blazra/tdr/README.md

# TDR
TDR using Lattice ECP5 High Data Rate Transceiver
