blazra/tdr/docs/index.md

## TDR Docs

TDR [Interactive BOM](bom/ibom.html)
