blazra/tdr/boards/TDR/TDR.kicad_pcb

## KiCad design boards/TDR/TDR.kicad_pcb (2020-08-01)

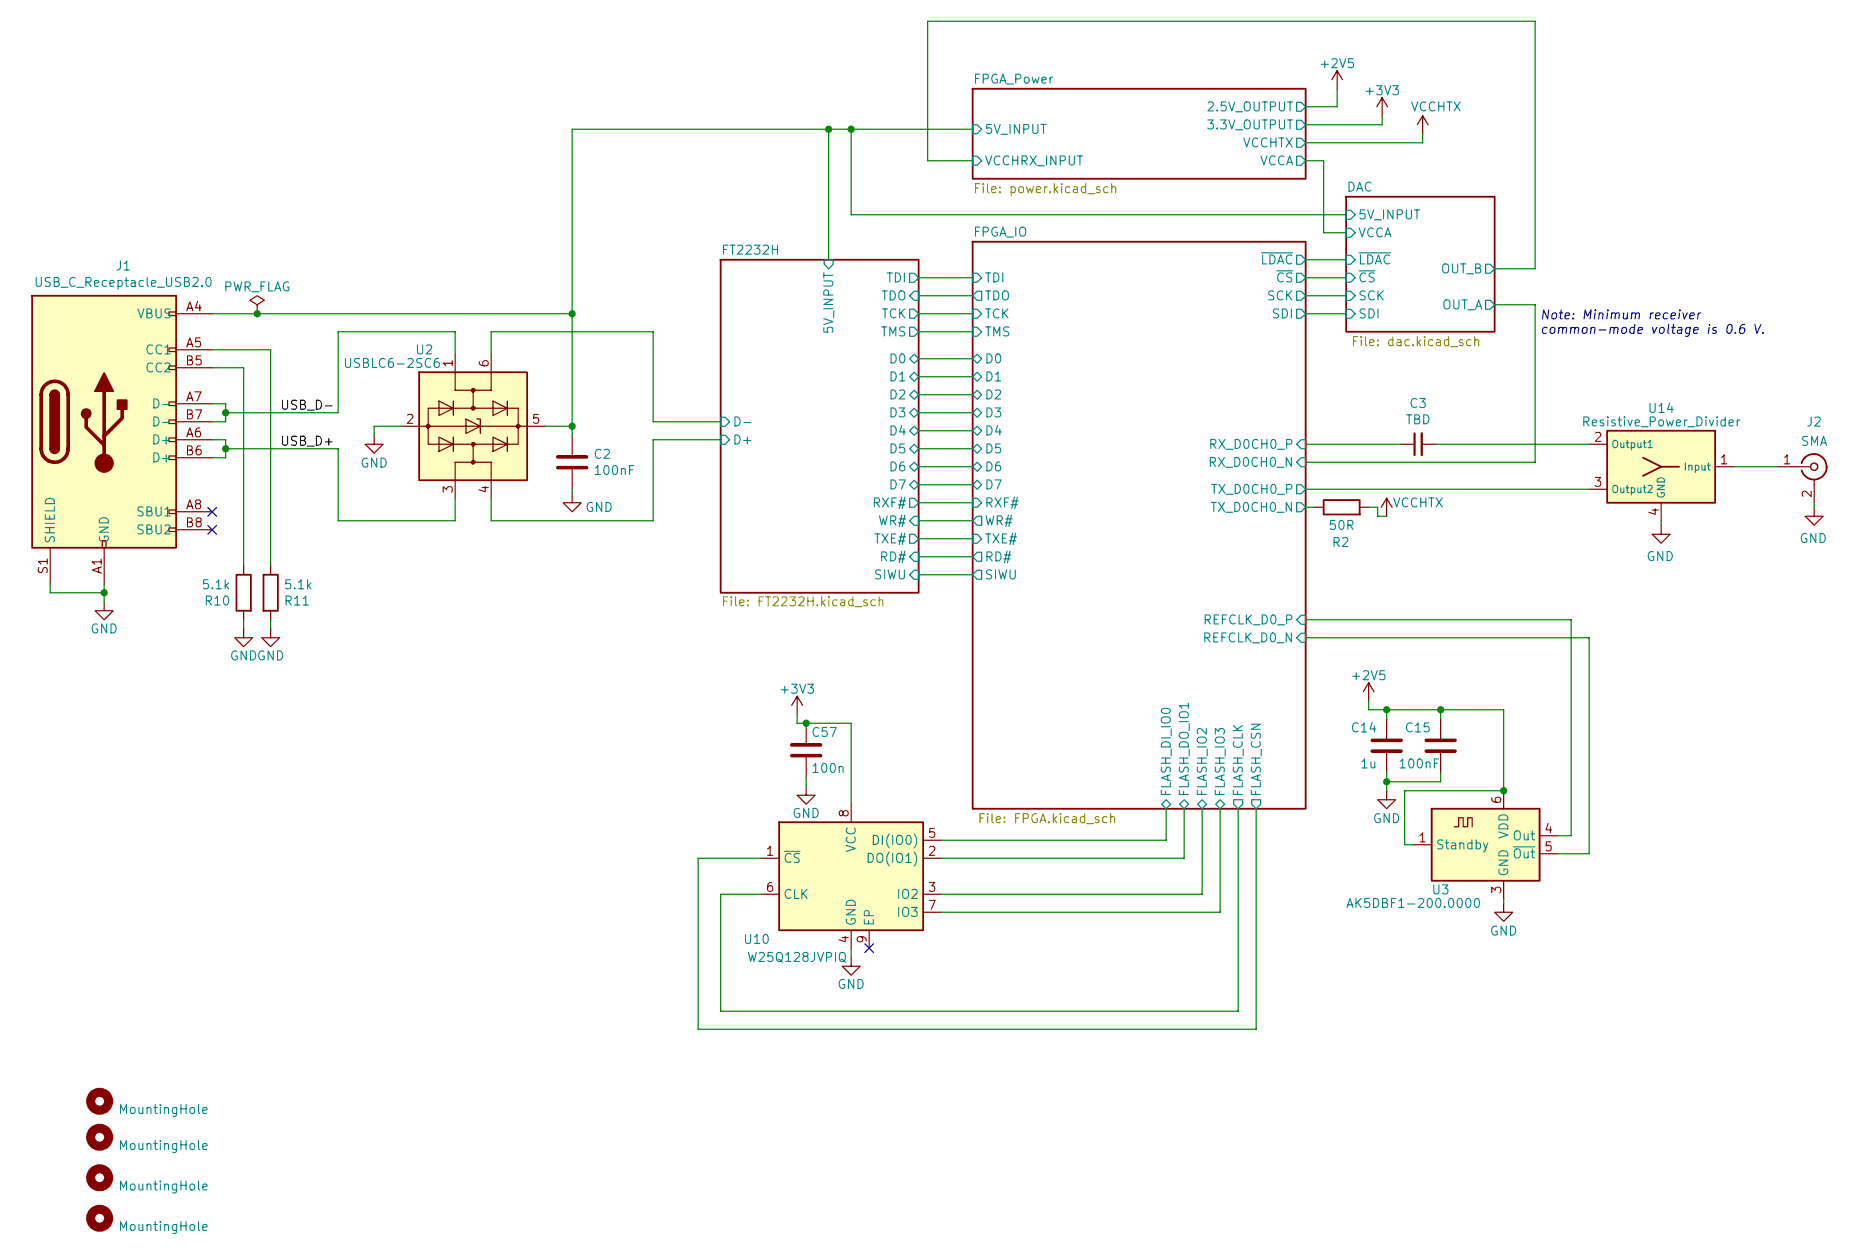
[picture p1: schematic TDR.kicad_sch, TDR, Top schematic]

Parts:
C2, C15: 100nF; C_0402_1005Metric
C3: TBD; C_0402_1005Metric
C14: 1u; C_0805_2012Metric
C57: 100n; C_0402_1005Metric
H1, H2, H3, H4: MountingHole; MountingHole_3.2mm_M3
J1: USB_C_Receptacle_USB2.0; USB_C_Receptacle_JAE_DX07S016
J2: SMA; Rosenberger_SMA_32K243-40ML5
R2: 50R; R_0402_1005Metric
R10, R11: 5.1k; R_0805_2012Metric
U2: USBLC6-2SC6; SOT-23-6
U3: AK5DBF1-200.0000; Oscillator_SMD_IDT_JS6-6_5.0x3.2mm_P1.27mm
U10: W25Q128JVPIQ; WSON-8-1EP_6x5mm_P1.27mm_EP3.4x4.3mm
U14: Resistive_Power_Divider; Susumu_PS2012G

Connections:
+2V5: C14.1, C15.1, U3.1 (Standby), U3.6 (VDD); also elsewhere on the board
+3V3: C57.1, U10.8 (VCC); also elsewhere on the board
/5V_INPUT: C2.1, J1.A4 (VBUS), J1.A9 (VBUS), J1.B4 (VBUS), J1.B9 (VBUS), U2.5 (VBUS); also elsewhere on the board
/D+: U2.4 (I/O2); also elsewhere on the board
/D-: U2.6 (I/O1); also elsewhere on the board
/FLASH_CLK: U10.6 (CLK); also elsewhere on the board
/FLASH_CSN: U10.1 (~CS); also elsewhere on the board
/FLASH_DI_IO0: U10.5 (DI(IO0)); also elsewhere on the board
/FLASH_DO_IO1: U10.2 (DO(IO1)); also elsewhere on the board
/FLASH_IO2: U10.3 (IO2); also elsewhere on the board
/FLASH_IO3: U10.7 (IO3); also elsewhere on the board
/REFCLK_D0_N: U3.5 (~Out); also elsewhere on the board
/REFCLK_D0_P: U3.4 (Out); also elsewhere on the board
/RX_D0CH0_P: C3.1; also elsewhere on the board
/TX_D0CH0_N: R2.1; also elsewhere on the board
/TX_D0CH0_P: U14.3 (Output2); also elsewhere on the board
/USB_D+: J1.A6 (D+), J1.B6 (D+), U2.3 (I/O2)
/USB_D-: J1.A7 (D-), J1.B7 (D-), U2.1 (I/O1)
GND: C2.2, C14.2, C15.2, C57.2, J1.A1 (GND), J1.A12 (GND), J1.B1 (GND), J1.B12 (GND), J1.S1 (SHIELD), J2.2 (Ext), R10.2, R11.2, U2.2 (GND), U3.3 (GND), U10.4 (GND), U14.4 (GND); also elsewhere on the board
unnamed: C3.2, U14.2 (Output1)
unnamed: J1.A5 (CC1), R11.1
unnamed: J1.B5 (CC2), R10.1
unnamed: J2.1 (In), U14.1 (Input)
VCCHTX: R2.2; also elsewhere on the board

Notes on the sheet:
Note: Minimum receiver common-mode voltage is 0.6 V.

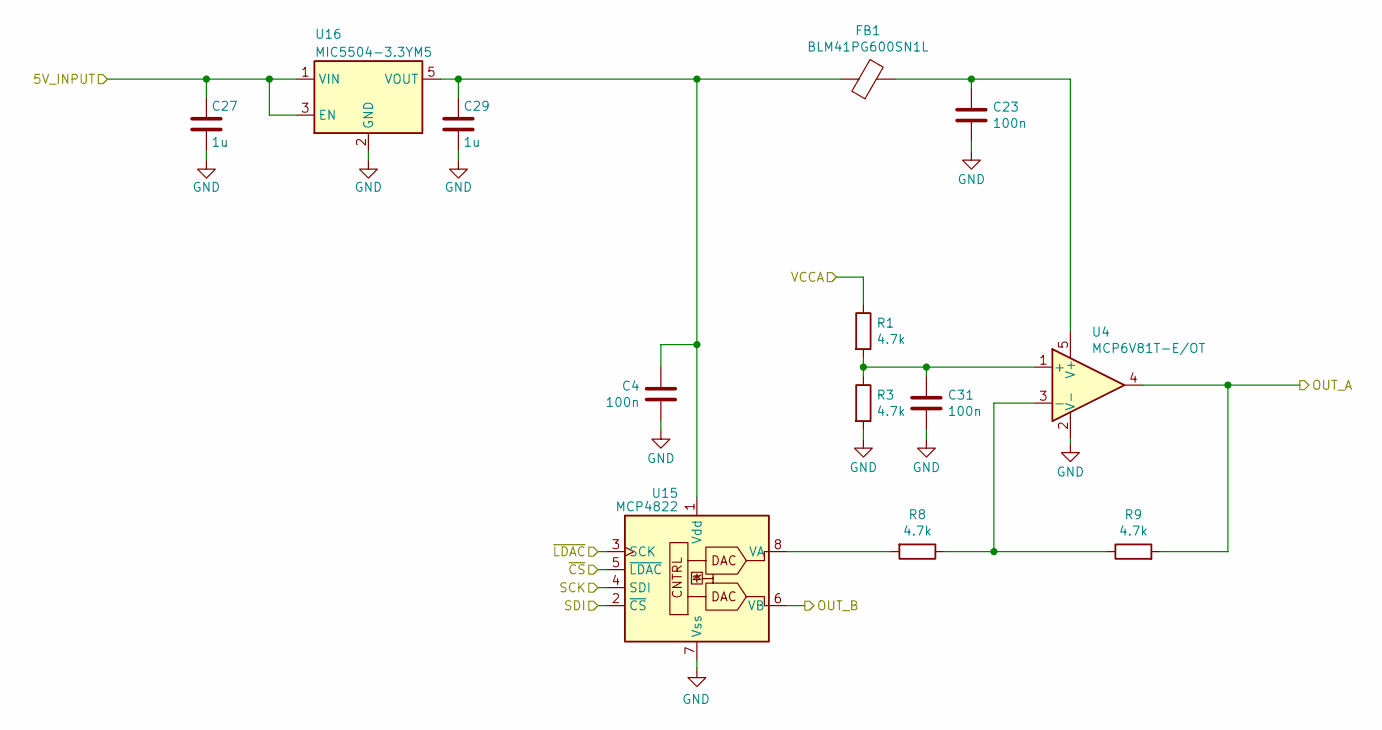
[picture p2: schematic dac.kicad_sch]

Parts:
C4, C23, C31: 100n; C_0402_1005Metric
C27, C29: 1u; C_0805_2012Metric
FB1: BLM41PG600SN1L; L_1806_4516Metric
R1, R3, R8, R9: 4.7k; R_0805_2012Metric
U4: MCP6V81T-E/OT; SOT-23-5
U15: MCP4822; MSOP-8_3x3mm_P0.65mm
U16: MIC5504-3.3YM5; SOT-23-5

Connections:
/5V_INPUT: C27.1, U16.1 (VIN), U16.3 (EN); also elsewhere on the board
/OUT_A: R9.2, U4.4; also elsewhere on the board
/OUT_B: U15.6 (VB); also elsewhere on the board
/SCK: U15.4 (SDI); also elsewhere on the board
/SDI: U15.2 (~CS); also elsewhere on the board
/VCCA: R1.1; also elsewhere on the board
/~CS: U15.5 (~LDAC); also elsewhere on the board
/~LDAC: U15.3 (SCK); also elsewhere on the board
GND: C4.2, C23.2, C27.2, C29.2, C31.1, R3.2, U4.2 (V-), U15.7 (Vss), U16.2 (GND); also elsewhere on the board
unnamed: C23.1, FB1.2, U4.5 (V+)
unnamed: C4.1, C29.1, FB1.1, U15.1 (Vdd), U16.5 (VOUT)
unnamed: C31.2, R1.2, R3.1, U4.1 (+)
unnamed: R8.1, R9.1, U4.3 (-)
unnamed: R8.2, U15.8 (VA)

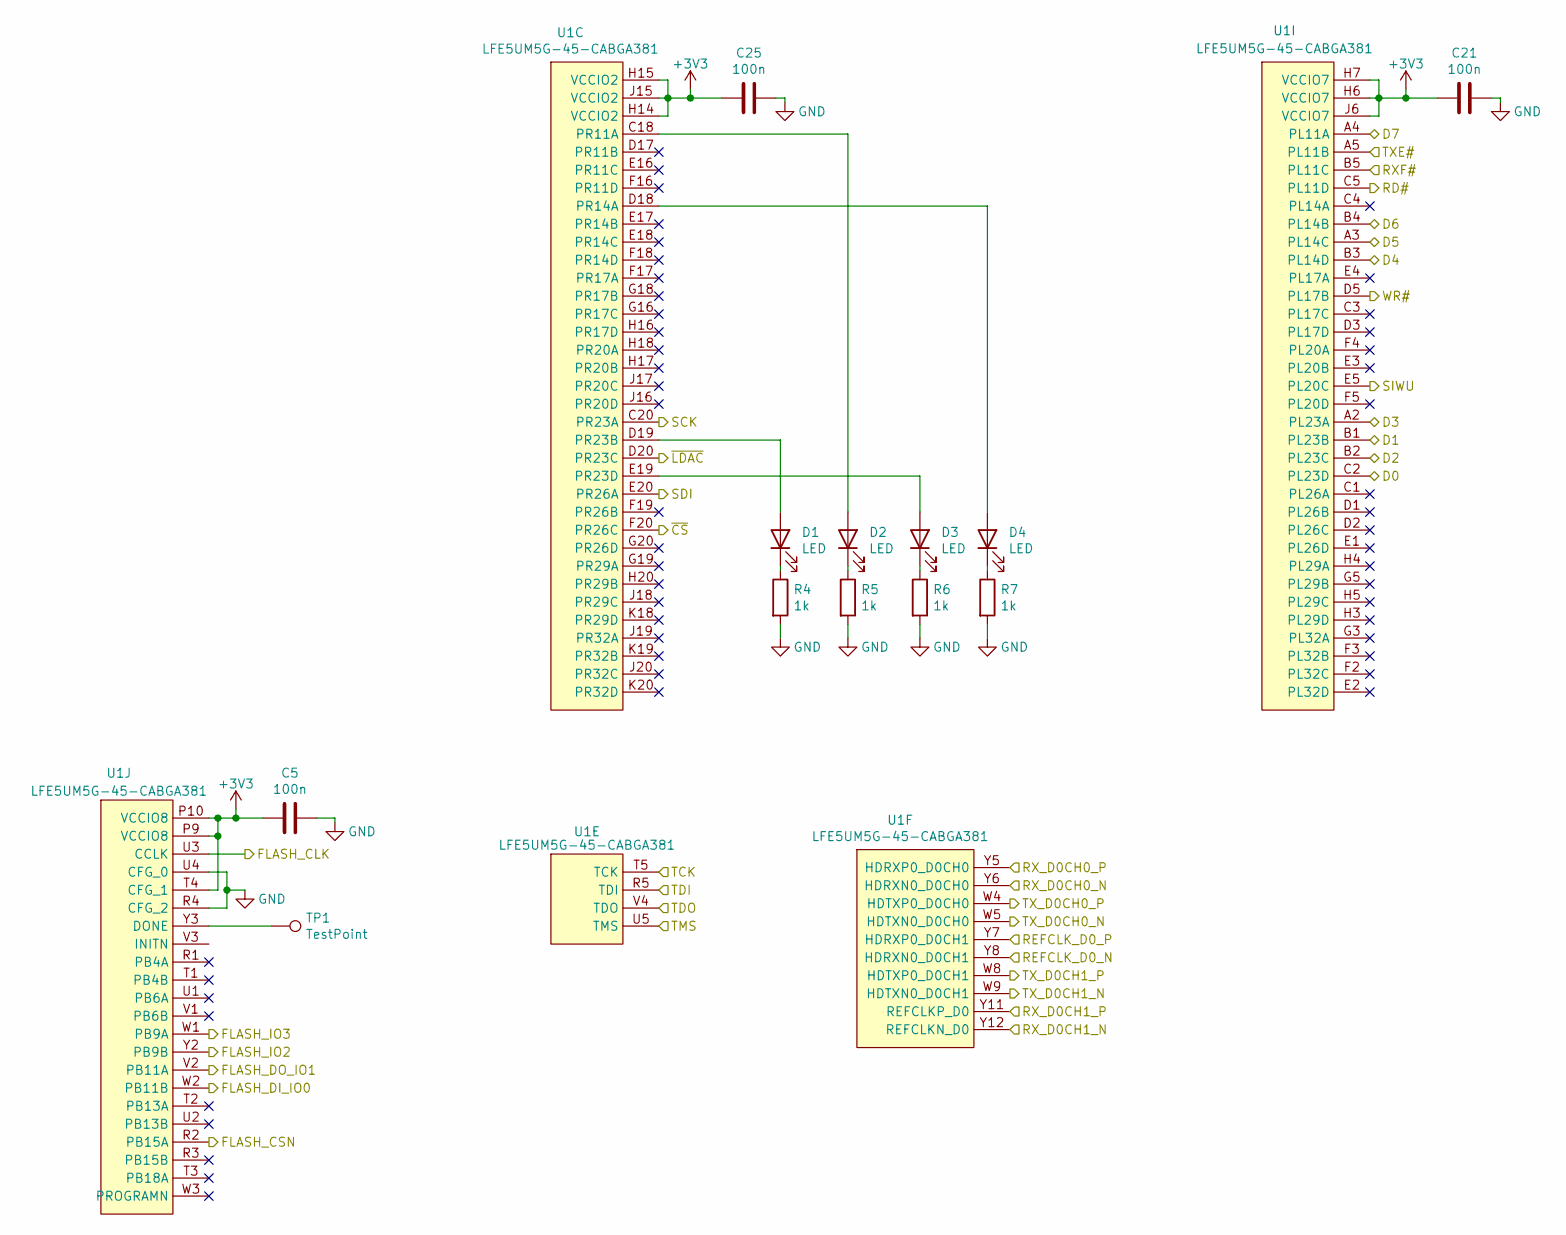
[picture p3: schematic FPGA.kicad_sch, TDR, FPGA IO]

Parts:
C5, C21, C25: 100n; C_0402_1005Metric
D1, D2, D3, D4: LED; LED_0805_2012Metric_Castellated
R4, R5, R6, R7: 1k; R_0805_2012Metric
TP1: TestPoint; TestPoint_Pad_D1.0mm
U1: LFE5UM5G-45-CABGA381; Lattice_caBGA-381_17.0x17.0mm_Layout20x20_P0.8mm_Ball0.4mm_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

Connections:
+3V3: C5.1, C21.1, C25.1, U1.H6 (VCCIO7), U1.H7 (VCCIO7), U1.H14 (VCCIO2), U1.H15 (VCCIO2), U1.J6 (VCCIO7), U1.J15 (VCCIO2), U1.P9 (VCCIO8), U1.P10 (VCCIO8), U1.T4 (CFG_1); also elsewhere on the board
/D0: U1.C2 (PL23D); also elsewhere on the board
/D1: U1.B1 (PL23B); also elsewhere on the board
/D2: U1.B2 (PL23C); also elsewhere on the board
/D3: U1.A2 (PL23A); also elsewhere on the board
/D4: U1.B3 (PL14D); also elsewhere on the board
/D5: U1.A3 (PL14C); also elsewhere on the board
/D6: U1.B4 (PL14B); also elsewhere on the board
/D7: U1.A4 (PL11A); also elsewhere on the board
/FLASH_CLK: U1.U3 (CCLK); also elsewhere on the board
/FLASH_CSN: U1.R2 (PB15A); also elsewhere on the board
/FLASH_DI_IO0: U1.W2 (PB11B); also elsewhere on the board
/FLASH_DO_IO1: U1.V2 (PB11A); also elsewhere on the board
/FLASH_IO2: U1.Y2 (PB9B); also elsewhere on the board
/FLASH_IO3: U1.W1 (PB9A); also elsewhere on the board
/FPGA_IO/RX_D0CH1_N: U1.Y12 (REFCLKN_D0)
/FPGA_IO/RX_D0CH1_P: U1.Y11 (REFCLKP_D0)
/FPGA_IO/TX_D0CH1_N: U1.W9 (HDTXN0_D0CH1)
/FPGA_IO/TX_D0CH1_P: U1.W8 (HDTXP0_D0CH1)
/OUT_A: U1.Y6 (HDRXN0_D0CH0); also elsewhere on the board
/RD#: U1.C5 (PL11D); also elsewhere on the board
/REFCLK_D0_N: U1.Y8 (HDRXN0_D0CH1); also elsewhere on the board
/REFCLK_D0_P: U1.Y7 (HDRXP0_D0CH1); also elsewhere on the board
/RXF#: U1.B5 (PL11C); also elsewhere on the board
/RX_D0CH0_P: U1.Y5 (HDRXP0_D0CH0); also elsewhere on the board
/SCK: U1.C20 (PR23A); also elsewhere on the board
/SDI: U1.E20 (PR26A); also elsewhere on the board
/SIWU: U1.E5 (PL20C); also elsewhere on the board
/TCK: U1.T5 (TCK); also elsewhere on the board
/TDI: U1.R5 (TDI); also elsewhere on the board
/TDO: U1.V4 (TDO); also elsewhere on the board
/TMS: U1.U5 (TMS); also elsewhere on the board
/TXE#: U1.A5 (PL11B); also elsewhere on the board
/TX_D0CH0_N: U1.W5 (HDTXN0_D0CH0); also elsewhere on the board
/TX_D0CH0_P: U1.W4 (HDTXP0_D0CH0); also elsewhere on the board
/WR#: U1.D5 (PL17B); also elsewhere on the board
/~CS: U1.F20 (PR26C); also elsewhere on the board
/~LDAC: U1.D20 (PR23C); also elsewhere on the board
GND: C5.2, C21.2, C25.2, R4.2, R5.2, R6.2, R7.2, U1.R4 (CFG_2), U1.U4 (CFG_0); also elsewhere on the board
unnamed: D1.1 (K), R4.1
unnamed: D1.2 (A), U1.D19 (PR23B)
unnamed: D2.1 (K), R5.1
unnamed: D2.2 (A), U1.C18 (PR11A)
unnamed: D3.1 (K), R6.1
unnamed: D3.2 (A), U1.E19 (PR23D)
unnamed: D4.1 (K), R7.1
unnamed: D4.2 (A), U1.D18 (PR14A)
unnamed: TP1.1, U1.Y3 (DONE)

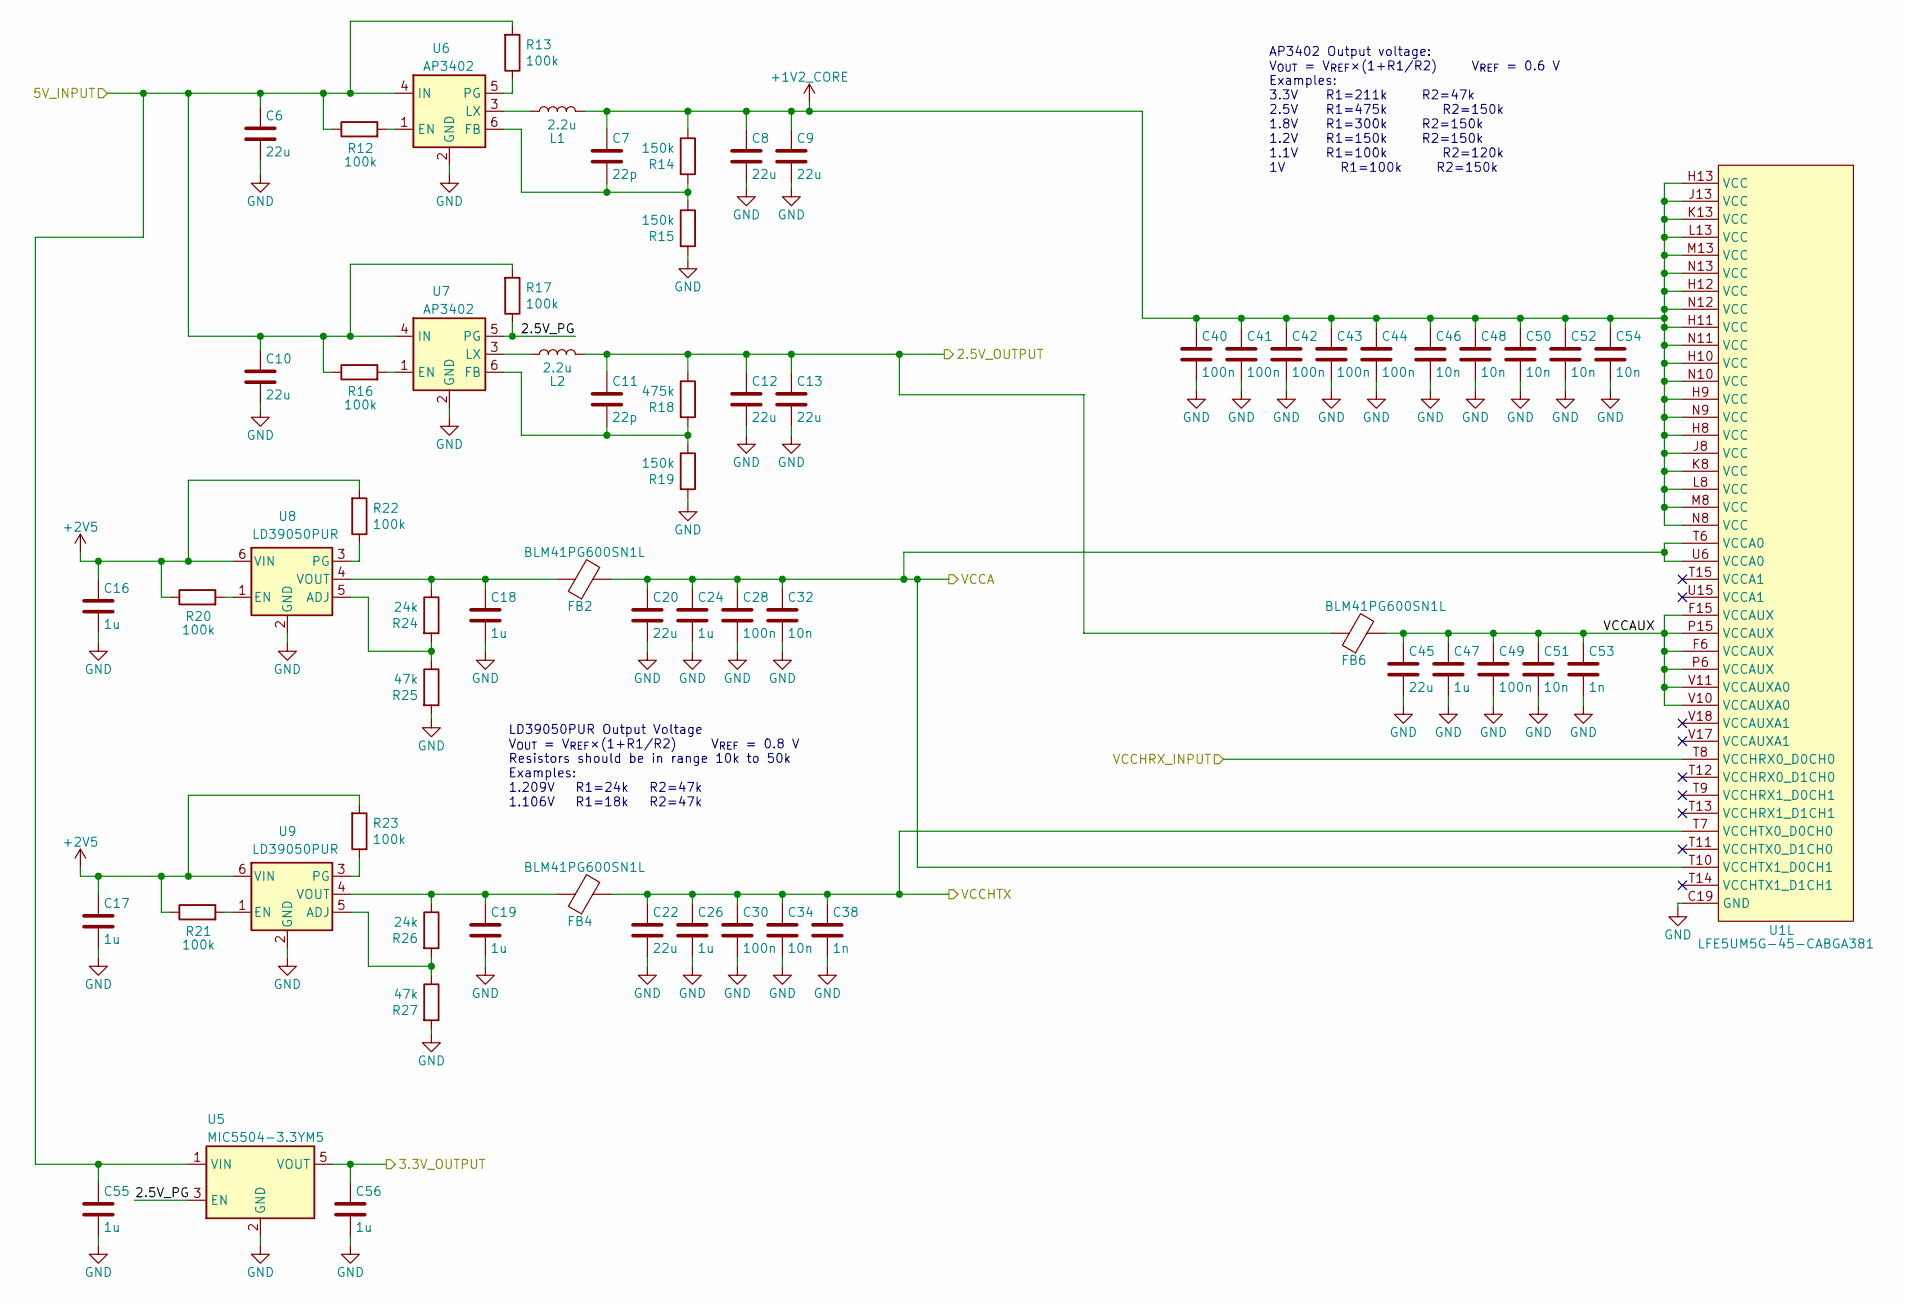
[picture p4: schematic power.kicad_sch, TDR, FPGA Power]

Parts:
C6, C8, C9, C10, C12, C13, C20, C22, C45: 22u; C_0805_2012Metric
C7, C11: 22p; C_0805_2012Metric
C16, C17, C18, C19, C24, C26, C47, C55, C56: 1u; C_0805_2012Metric
C28, C30, C40, C41, C42, C43, C44, C49: 100n; C_0402_1005Metric
C32, C34, C46, C48, C50, C51, C52, C54: 10n; C_0402_1005Metric
C38, C53: 1n; C_0402_1005Metric
FB2, FB4, FB6: BLM41PG600SN1L; L_1806_4516Metric
L1, L2: 2.2u; L_Ferrocore_HPI0530
R12, R13, R16, R17, R20, R21, R22, R23: 100k; R_0805_2012Metric
R14, R15, R19: 150k; R_0805_2012Metric
R18: 475k; R_0805_2012Metric
R24, R26: 24k; R_0805_2012Metric
R25, R27: 47k; R_0805_2012Metric
U1: LFE5UM5G-45-CABGA381; Lattice_caBGA-381_17.0x17.0mm_Layout20x20_P0.8mm_Ball0.4mm_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
U5: MIC5504-3.3YM5; SOT-23-5
U6, U7: AP3402; SOT-23-6
U8, U9: LD39050PUR; DFN-6-1EP_3x3mm_P0.95mm_EP1.7x2.6mm

Connections:
+1V2_CORE: C7.1, C8.1, C9.1, C40.1, C41.1, C42.1, C43.1, C44.1, C46.1, C48.1, C50.1, C52.1, C54.1, L1.2, R14.1, U1.H8 (VCC), U1.H9 (VCC), U1.H10 (VCC), U1.H11 (VCC), U1.H12 (VCC), U1.H13 (VCC), U1.J8 (VCC), U1.J13 (VCC), U1.K8 (VCC), U1.K13 (VCC), U1.L8 (VCC), U1.L13 (VCC), U1.M8 (VCC), U1.M13 (VCC), U1.N8 (VCC), U1.N9 (VCC), U1.N10 (VCC), U1.N11 (VCC), U1.N12 (VCC), U1.N13 (VCC)
+2V5: C11.1, C12.1, C13.1, C16.1, C17.1, FB6.1, L2.2, R18.1, R20.1, R21.1, R22.2, R23.2, U8.6 (VIN), U9.6 (VIN); also elsewhere on the board
+3V3: C56.1, U5.5 (VOUT); also elsewhere on the board
/5V_INPUT: C6.1, C10.1, C55.1, R12.1, R13.2, R16.1, R17.2, U5.1 (VIN), U6.4 (IN), U7.4 (IN); also elsewhere on the board
/FPGA_Power/2.5V_PG: R17.1, U5.3 (EN), U7.5 (PG)
/FPGA_Power/VCCAUX: C45.1, C47.1, C49.1, C51.1, C53.1, FB6.2, U1.F6 (VCCAUX), U1.F15 (VCCAUX), U1.P6 (VCCAUX), U1.P15 (VCCAUX), U1.V10 (VCCAUXA0), U1.V11 (VCCAUXA0)
/OUT_B: U1.T8 (VCCHRX0_D0CH0); also elsewhere on the board
/VCCA: C20.1, C24.1, C28.1, C32.1, FB2.2, U1.T6 (VCCA0), U1.T10 (VCCHTX1_D0CH1), U1.U6 (VCCA0); also elsewhere on the board
GND: C6.2, C8.2, C9.2, C10.2, C12.2, C13.2, C16.2, C17.2, C18.2, C19.2, C20.2, C22.2, C24.2, C26.2, C28.2, C30.2, C32.2, C34.2, C38.2, C40.2, C41.2, C42.2, C43.2, C44.2, C45.2, C46.2, C47.2, C48.2, C49.2, C50.2, C51.2, C52.2, C53.2, C54.2, C55.2, C56.2, R15.2, R19.2, R25.2, R27.2, U1.B7 (GND), U1.B14 (GND), U1.C19 (GND), U1.D4 (GND), U1.F7 (GND), U1.F8 (GND), U1.F13 (GND), U1.F14 (GND), U1.G4 (GND), U1.G6 (GND), U1.G7 (GND), U1.G8 (GND), U1.G9 (GND), U1.G10 (GND), U1.G11 (GND), U1.G12 (GND), U1.G13 (GND), U1.G14 (GND), U1.G15 (GND), U1.G17 (GND), U1.H19 (GND), U1.J2 (GND), U1.J7 (GND), U1.J9 (GND), U1.J10 (GND), U1.J11 (GND), U1.J12 (GND), U1.J14 (GND), U1.K6 (GND), U1.K7 (GND), U1.K9 (GND), U1.K10 (GND), U1.K11 (GND), U1.K12 (GND), U1.K14 (GND), U1.K15 (GND), U1.L9 (GND), U1.L10 (GND), U1.L11 (GND), U1.L12 (GND), U1.M2 (GND), U1.M7 (GND), U1.M9 (GND), U1.M10 (GND), U1.M11 (GND), U1.M12 (GND), U1.M14 (GND), U1.M16 (GND), U1.N6 (GND), U1.N7 (GND), U1.N14 (GND), U1.N15 (GND), U1.P7 (GND), U1.P8 (GND), U1.P11 (GND), U1.P12 (GND), U1.P13 (GND), U1.P14 (GND), U1.R19 (GND), U1.U7 (GND), U1.U8 (GND), U1.U9 (GND), U1.U10 (GND), U1.U11 (GND), U1.U12 (GND), U1.U13 (GND), U1.U14 (GND), U1.V5 (GND), U1.V6 (GND), U1.V7 (GND), U1.V8 (GND), U1.V9 (GND), U1.V12 (GND), U1.V13 (GND), U1.V14 (GND), U1.V15 (GND), U1.V16 (GND), U1.V19 (GND), U1.V20 (GND), U1.W6 (GND), U1.W7 (GND), U1.W12 (GND), U1.W15 (GND), U1.W16 (GND), U1.W19 (GND), U5.2 (GND), U6.2 (GND), U7.2 (GND), U8.2 (GND), U9.2 (GND); also elsewhere on the board
unnamed: C7.2, R14.2, R15.1, U6.6 (FB)
unnamed: C11.2, R18.2, R19.1, U7.6 (FB)
unnamed: C18.1, FB2.1, R24.1, U8.4 (VOUT)
unnamed: C19.1, FB4.1, R26.1, U9.4 (VOUT)
unnamed: L1.1, U6.3 (LX)
unnamed: L2.1, U7.3 (LX)
unnamed: R12.2, U6.1 (EN)
unnamed: R13.1, U6.5 (PG)
unnamed: R16.2, U7.1 (EN)
unnamed: R20.2, U8.1 (EN)
unnamed: R21.2, U9.1 (EN)
unnamed: R22.1, U8.3 (PG)
unnamed: R23.1, U9.3 (PG)
unnamed: R24.2, R25.1, U8.5 (ADJ)
unnamed: R26.2, R27.1, U9.5 (ADJ)
VCCHTX: C22.1, C26.1, C30.1, C34.1, C38.1, FB4.2, U1.T7 (VCCHTX0_D0CH0); also elsewhere on the board

Notes on the sheet:
LD39050PUR Output Voltage V_{OUT} = V_{REF}×(1+R1/R2) V_{REF} = 0.8 V Resistors should be in range 10k to 50k Examples: 1.209V R1=24k R2=47k 1.106V R1=18k R2=47k
AP3402 Output voltage: V_{OUT} = V_{REF}×(1+R1/R2) V_{REF} = 0.6 V Examples: 3.3V R1=211k R2=47k 2.5V R1=475k R2=150k 1.8V R1=300k R2=150k 1.2V R1=150k R2=150k 1.1V R1=100k R2=120k 1V R1=100k R2=150k

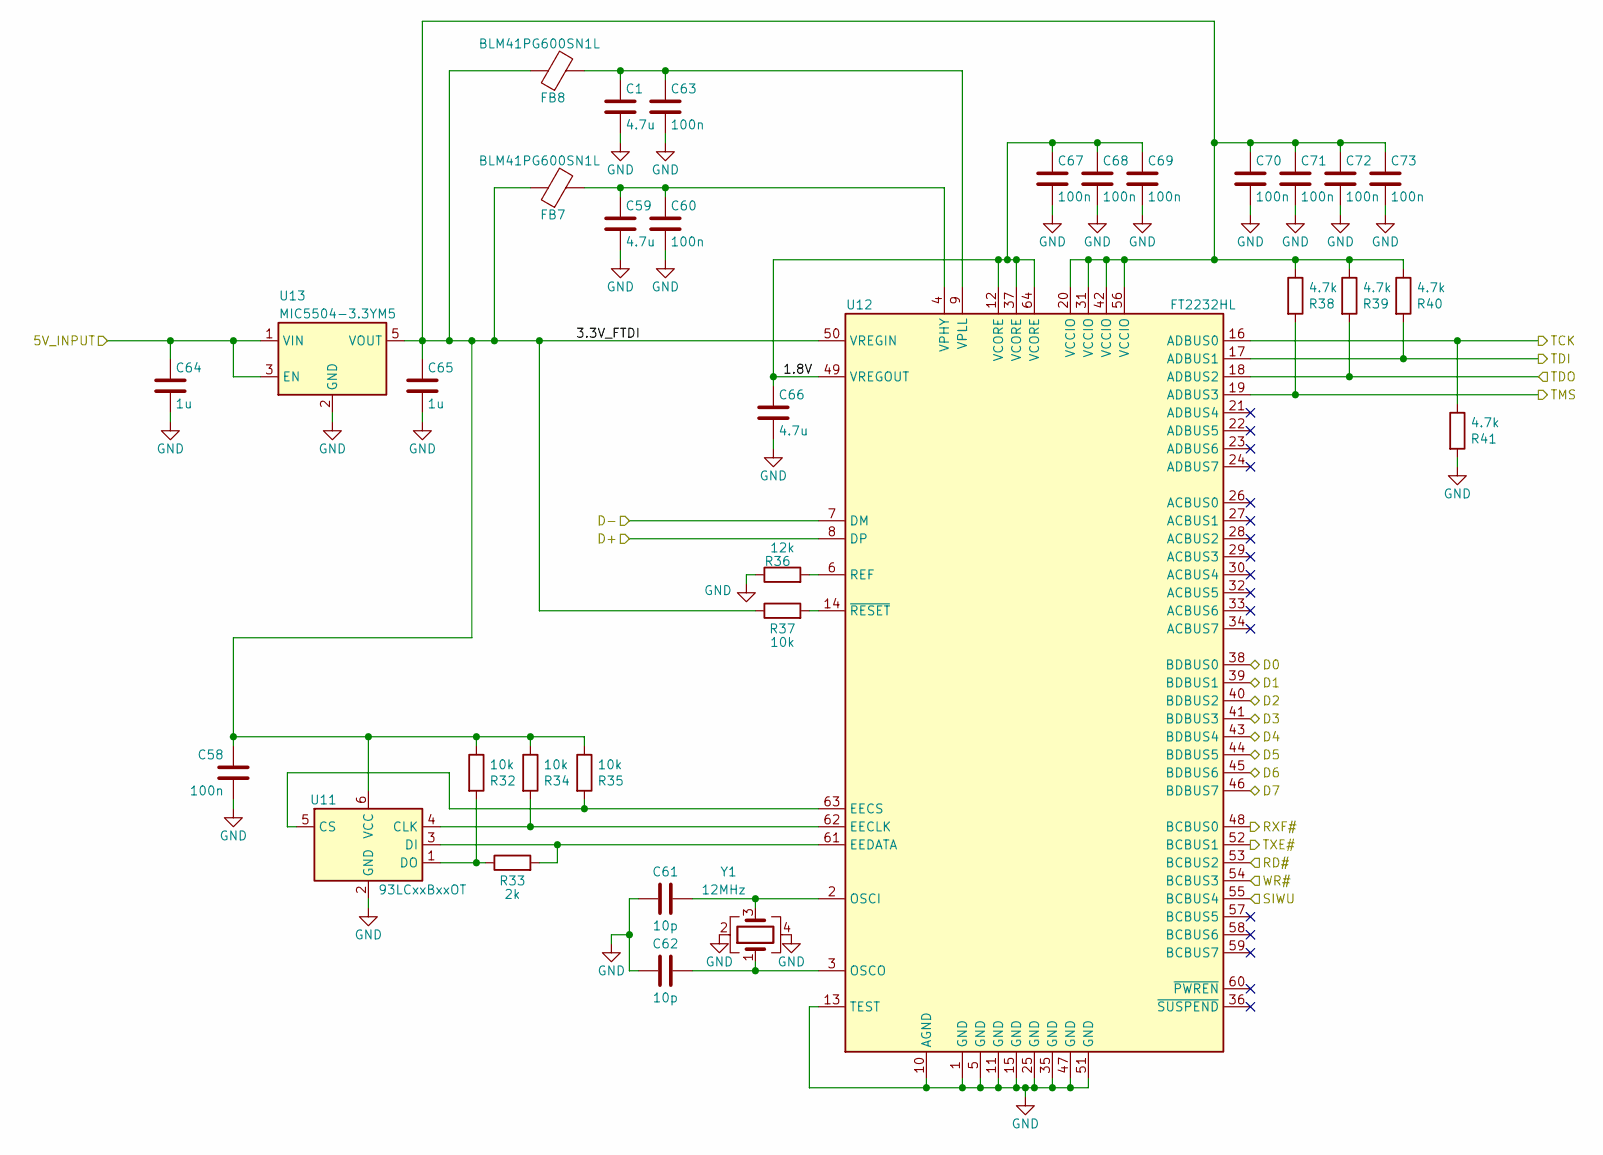
[picture p5: schematic FT2232H.kicad_sch, TDR, FT2232]

Parts:
C1, C59, C66: 4.7u; C_0805_2012Metric
C58, C60, C63, C67, C68, C69, C70, C71, C72, C73: 100n; C_0402_1005Metric
C61, C62: 10p; C_0805_2012Metric
C64, C65: 1u; C_0805_2012Metric
FB7, FB8: BLM41PG600SN1L; L_1806_4516Metric
R32, R34, R35, R37: 10k; R_0805_2012Metric
R33: 2k; R_0805_2012Metric
R36: 12k; R_0805_2012Metric
R38, R39, R40, R41: 4.7k; R_0805_2012Metric
U11: 93LCxxBxxOT; SOT-23-6
U12: FT2232HL; LQFP-64_10x10mm_P0.5mm
U13: MIC5504-3.3YM5; SOT-23-5
Y1: 12MHz; Crystal_SMD_3225-4Pin_3.2x2.5mm

Connections:
/5V_INPUT: C64.1, U13.1 (VIN), U13.3 (EN); also elsewhere on the board
/D0: U12.38 (BDBUS0); also elsewhere on the board
/D1: U12.39 (BDBUS1); also elsewhere on the board
/D2: U12.40 (BDBUS2); also elsewhere on the board
/D3: U12.41 (BDBUS3); also elsewhere on the board
/D4: U12.43 (BDBUS4); also elsewhere on the board
/D5: U12.44 (BDBUS5); also elsewhere on the board
/D6: U12.45 (BDBUS6); also elsewhere on the board
/D7: U12.46 (BDBUS7); also elsewhere on the board
/D+: U12.8 (DP); also elsewhere on the board
/D-: U12.7 (DM); also elsewhere on the board
/FT2232H/1.8V: C66.1, C67.1, C68.1, C69.1, U12.12 (VCORE), U12.37 (VCORE), U12.49 (VREGOUT), U12.64 (VCORE)
/FT2232H/3.3V_FTDI: C58.2, C65.1, C70.1, C71.1, C72.1, C73.1, FB7.1, FB8.1, R32.1, R34.1, R35.1, R37.1, R38.1, R39.1, R40.1, U11.6 (VCC), U12.20 (VCCIO), U12.31 (VCCIO), U12.42 (VCCIO), U12.50 (VREGIN), U12.56 (VCCIO), U13.5 (VOUT)
/RD#: U12.53 (BCBUS2); also elsewhere on the board
/RXF#: U12.48 (BCBUS0); also elsewhere on the board
/SIWU: U12.55 (BCBUS4); also elsewhere on the board
/TCK: R41.1, U12.16 (ADBUS0); also elsewhere on the board
/TDI: R40.2, U12.17 (ADBUS1); also elsewhere on the board
/TDO: R39.2, U12.18 (ADBUS2); also elsewhere on the board
/TMS: R38.2, U12.19 (ADBUS3); also elsewhere on the board
/TXE#: U12.52 (BCBUS1); also elsewhere on the board
/WR#: U12.54 (BCBUS3); also elsewhere on the board
GND: C1.2, C58.1, C59.2, C60.2, C61.1, C62.1, C63.2, C64.2, C65.2, C66.2, C67.2, C68.2, C69.2, C70.2, C71.2, C72.2, C73.2, R36.1, R41.2, U11.2 (GND), U12.1 (GND), U12.5 (GND), U12.10 (AGND), U12.11 (GND), U12.13 (TEST), U12.15 (GND), U12.25 (GND), U12.35 (GND), U12.47 (GND), U12.51 (GND), U13.2 (GND), Y1.2, Y1.4; also elsewhere on the board
unnamed: C1.1, C63.1, FB8.2, U12.9 (VPLL)
unnamed: C59.1, C60.1, FB7.2, U12.4 (VPHY)
unnamed: C61.2, U12.2 (OSCI), Y1.3
unnamed: C62.2, U12.3 (OSCO), Y1.1
unnamed: R32.2, R33.1, U11.1 (DO)
unnamed: R33.2, U11.3 (DI), U12.61 (EEDATA)
unnamed: R34.2, U11.4 (CLK), U12.62 (EECLK)
unnamed: R35.2, U11.5 (CS), U12.63 (EECS)
unnamed: R36.2, U12.6 (REF)
unnamed: R37.2, U12.14 (~RESET)

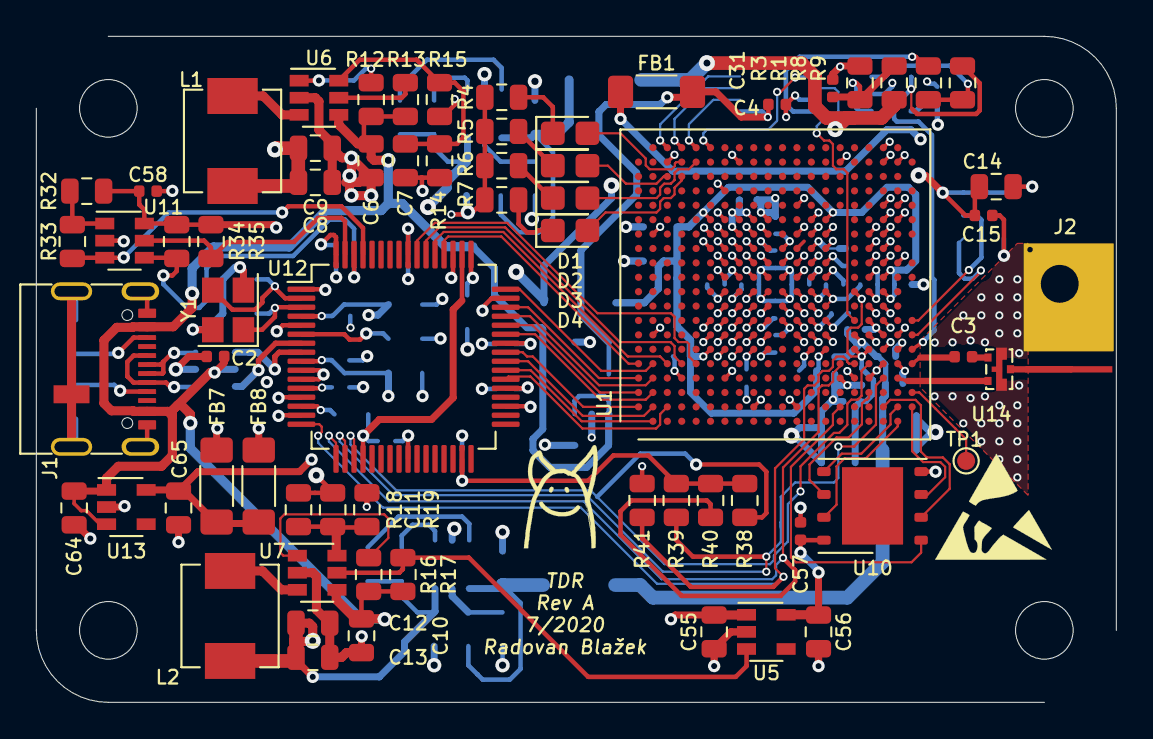
[picture p6: board TDR.kicad_pcb from above]

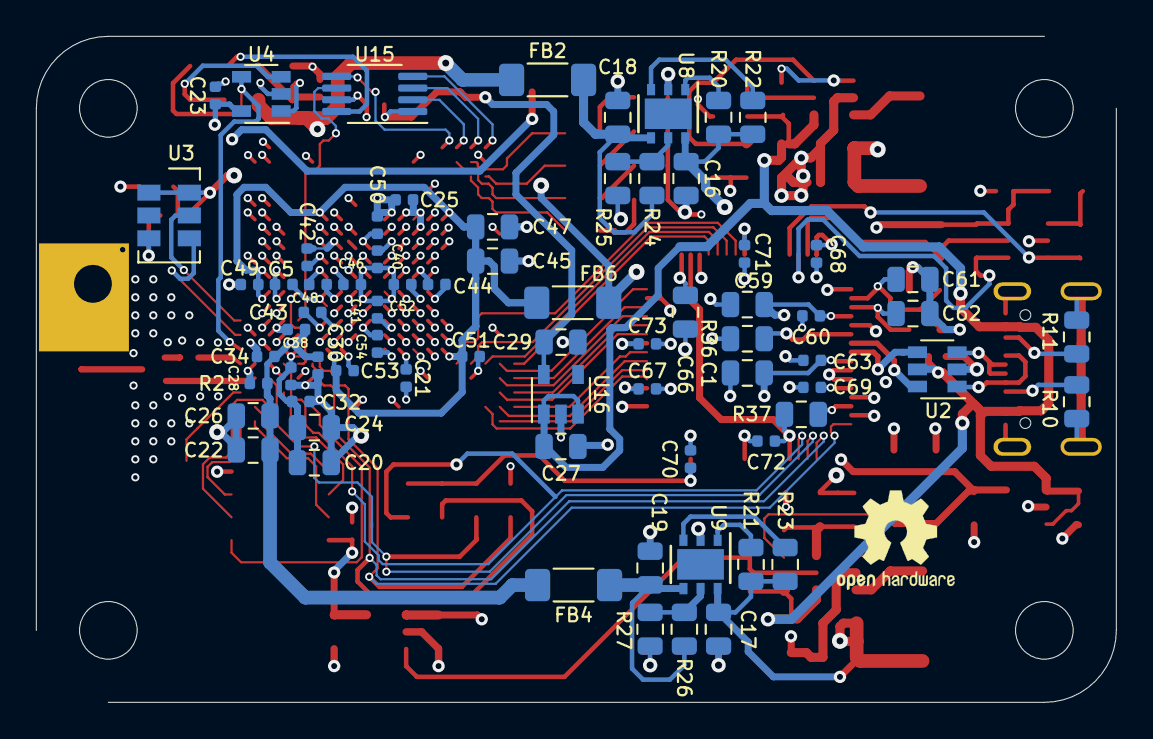
[picture p7: board TDR.kicad_pcb from below]

Board: 4 copper layers, 60.0 x 37.0 mm, 141 parts (71 on the bottom side), 92 nets.
