blazra/tdr/(threads)

Thread 3 (2020-08-03):

SMA connector has no side clearance from the solder mask

blazra, 2020-08-03:
