blazra/tdr/(commit log)

2020-06-30 Add kicad pcb files
    [FPGA.kicad_sch, FT2232H.kicad_sch, TDR.kicad_pcb, TDR.kicad_sch, dac.kicad_sch, power.kicad_sch]
2020-07-06 change crystal footprint and roughly finish schematic
    [FPGA.kicad_sch, FT2232H.kicad_sch, TDR.kicad_pcb, TDR.kicad_sch, dac.kicad_sch, power.kicad_sch]
2020-07-06 change usb footprint, route a few connections
    [FPGA.kicad_sch, FT2232H.kicad_sch, TDR.kicad_pcb, TDR.kicad_sch, dac.kicad_sch, power.kicad_sch]
2020-07-07 connect fpga vccio to 3.3V, add decoupling, route some tracks
    [FPGA.kicad_sch, FT2232H.kicad_sch, TDR.kicad_pcb, TDR.kicad_sch, dac.kicad_sch, power.kicad_sch]
2020-07-09 route almost all nets except VCCA, VCCAUX and maybe some others
    [FPGA.kicad_sch, FT2232H.kicad_sch, TDR.kicad_pcb, TDR.kicad_sch, dac.kicad_sch, power.kicad_sch]
2020-07-10 solved DRC errors and routed few more nets
    [FPGA.kicad_sch, FT2232H.kicad_sch, TDR.kicad_pcb, TDR.kicad_sch, dac.kicad_sch, power.kicad_sch]
2020-07-10 add LEDs, only 9 unconnected items remaining
    [FPGA.kicad_sch, TDR.kicad_pcb, TDR.kicad_sch]
2020-07-10 change BGA dogbone stringer width to 0.2 mm, 7 unconncted
    [TDR.kicad_pcb]
2020-07-10 finish routing
    [TDR.kicad_pcb, TDR.kicad_sch, power.kicad_sch]
2020-07-10 finishing touches on the silkscreen
    [FPGA.kicad_sch, TDR.kicad_pcb, TDR.kicad_sch, power.kicad_sch]
2020-07-10 hopefully PCB is done
    [FPGA.kicad_sch, FT2232H.kicad_sch, TDR.kicad_pcb, TDR.kicad_sch, dac.kicad_sch]
2020-07-14 add gerbers, this is revision 1
    [TDR-B_Mask.gbr, TDR-B_Paste.gbr, TDR-B_SilkS.gbr, TDR-Back.gbr, TDR-Edge_Cuts.gbr, TDR-F_Mask.gbr, TDR-F_Paste.gbr, TDR-F_SilkS.gbr]
2020-08-01 Add LD39050PUR feedback resistor values, fixed regulator enable
    Fixes #1
    [FPGA.kicad_sch, FT2232H.kicad_sch, TDR.kicad_pcb, TDR.kicad_sch, dac.kicad_sch, power.kicad_sch]
